larivera-UVG/Estimulador-Nervio-Vago/Estimulador/README.md

# Módulo Estimulador - Sistema Terapia VNS

## Descripción:

## Códigos:

### Arduino IDE:
Archivos .INO desarrollados en el editor de Arduino para configurar los módulos individuales del microcontrolador ATSAMD21E18A sobre la plataforma Trinket M0. Los archivos son independientes y solo el archivo .Estimulador recopila todas las funciones de los otros módulos para su funcionamiento.

* Administración de Energía
* Conversión Analógico-Digital
* Comunicación SPI
* Memoria EEPROM
* Módulación por Ancho de Pulso (PWM)
* Temporizadores/Contadores

## Esquemáticos:
Diseños de circuitos realizados para la fabricación de PCBs y simulaciones.

### Altium Designer
Esquemáticos y diseño de los PCBs para los prototipos. Se incluyen las librerias de los componentes usados y creados para los diseños. 

* Módulo de Alimentación y Comunicación USB
* Adaptador QFN a DIP
* Adaptador SOIC-8 A DIP
* Módulo Estimulador

### LTspice
Simulación de circuitos para la construcción de un convertidor de voltaje a corriente empleando componentes discretos (amplificadores operacionales, transistores, resistencias, etc).

* Convertidor Voltaje a Corriente Discreto

## Documentación
Documento escrito del trabajo de graduación en formado PDF, hoja de datos de componentes utilizados y documentos sobre teoría de la epilepsia, terapia VNS y manuales técnicos de dispositivos de neuromodulación de la Compañia LivaNova, PLC.

* Epilepsia y Sistema de Terapia VNS
* Microcontrolador SAMD21
* Plataforma Trinket M0
* Tesis

# Contacto:
Gustavo Ordoñez - Ord16357@uvg.edu.gt
