larivera-UVG/Estimulador-Nervio-Vago/Programador/Esquemáticos/README.md

# En este folder están los esquemáticos de simulación o pcbs creados

## Esquemático de comunicación inalámbrica en Proteus | 10 de agosto 2020

- ByteRead.pdsprj: contiene el esquemático utilizado en la simulación de los programas SendTry.ino y ReadTry.ino

## Actualización 22 de noviembre 2020

- Se elimina el archivo ByteRead.pdsprj
- Se añaden los esquemáticos y los diseños de PCBs de los módulos SPSGRF-868 y SPSGRFC. 

## Actualización 5 de enero 2021
- Se eliminaron los esquemáticos y diseños de PCB de los módulos de SPSGRF(C)-868. 
- Se añadieron esquemáticos de conexión entre controladores y módulos RF.
- [Fuente RF24-Arduino](https://create.arduino.cc/projecthub/muhammad-aqib/nrf24l01-interfacing-with-arduino-wireless-communication-0c13d4). Los pines CE y CSN se pueden cambiar en el código de la varilla programadora. 
- [Fuente RF24-NodeMCU](https://how2electronics.com/esp8266-nrf24l01-gateway-arduino-node/)
