larivera-UVG/Estimulador-Nervio-Vago/Programador/Codigo-Python/README.md

# En este folder están las archivos de Python utilizados para pruebas

## Pruebas de interfaz gráfica y envío de parámetros desde ésta | 7 de junio 2020

- ComAP_GUI.py: archivo con una interfaz gráfica capaz de enviar un número entero a un Arduino por medio de comunicación serial. Este número indica la frecuencia a la que debe resonar un buzzer. 

## Pruebas de comunicación inalámbrica entre dos Arduinos enviando los parámetros desde Python | 17 de agosto 2020

- ProteusCom.py: archivo que envía los parámetros de estimulación a un Arduino en Proteus. 

## Pruebas de comunicación inalámbrica físicas entre dos Arduinos enviando los parámetros desde Python | 30 de agosto 2020
- GUI_PP.py: archivo que envía los parámetros de estimulación a un Arduino de manera física por medio de una interfaz gráfica.
- GUI_PP.exe: interfaz gráfica convertida en aplicación para poder ser utilizada en cualquier computadora sin necesidad de tener Python instalado. 

## Pruebas de comunicación entre PC (GUI en Python) y controlador de la varilla (NodeMcu) por medio de WiFi | 26 de septiembre de 2020
- NMWiFi.py: archivo con genera la interfaz gráfica con capacidad de enviar los parámetros al controlador por medio de WiFi

## Interfaz gráfica mejorada con soporte para comuniación por WiFi y/o comuniación serial (por USB) | 29 de septiembre de 2020
- NewGUI.py: archivo que genera una interfaz gráfica mejorada con al capacidad de enviar parámetros al ESP8266 por medio de WiFi o por medio del cable USB.

## Actualización 22 de noviembre de 2020
- Solo se deja el archivo NewGUI que es el archivo que implementa el software de programación.
