larivera-UVG/Estimulador-Nervio-Vago/Programador/Documentación/README.md

# En este folder están los documentación utilizada y la versión actualizada del trabajo final de tesis

## Actualización 10 de agosto 2020
- Primera versión de tesis con resultados actualizados 

## Actualización 17 de agosto 2020
### Versión actualizada de tesis con los resultados: 
- Comunicación exitosa entre Proteus y Python. Se logran enviar los parámetros de estimulación desde la terminal de Spyder (Python)

## Actualización 24 de agosto 2020
### Versión actualizada de tesis con los resultados: 
- Comunicación exitosa entre Proteus y Python con GUI. Los parámetros de estimulación se envían desde una interfaz gráfica fácil de usar.
- Comunicación inalámbrica física exitosa con módulos RF 433 MHz. Se envía el número 500 desde el transmisor y el Arduino con el receptor imprime el valor en el monitor serial. 

## Actualización 31 de agosto 2020
### Versión actualizada de tesis con los resultados: 
- Comunicación inalámbrica física (con módulos RF de 433 MHz) entre dos Arduinos exitosa. Se logran enviar y recibir los parámetros de estimulación de forma exitosa. 
- Creación de una aplicación para poder utilizar la interfaz gráfica de forma universal, sin necesidad de instalar Python.
- Búsqueda automática del puerto USB (serial) en el que está conectado el Arduino transmisor. 

## Actualización 18 de septiembre 2020
### Versión actualizada de tesis
- Comunicación exitosa entre NodeMcu y Arduino utilizando los módulos RF de 433 MHz. Los valores se envían de forma repetida. Se debe cambiar el código para resolver este problema.
- Todas las secciones terminadas. 

## Actualización 28 de septiembre 2020
### Versión actualizada de tesis
- Cambios solicitados por el asesor. Mejoras en el texto. 

## Actualización 22 de noviembre 2020
- Versión actualizada de tesis
- Manual de Usuario para el Módulo de Programación - Versión 0.1 

### Documentación añadida de los componentes utilizados
- SPSGRF.pdf: hoja de datos del módulo RF SPSGRF
- spirit1.pdf: hoja de datos del módulo SPIRIT1, utilizado por el módulo SPSGRF

## Actualización 5 de enero 2021
- Se elimina la documentación del módulo SPSGRF, ya que este no se utilizó. 
- Se añadió la hoja de datos del módulo nRF24L01+ 
- La librería de Arduino IDE utilizada para el manejo del módulo RF se encuentra en el link de abajo: 
* [Librería nRF24L01+](http://tmrh20.github.io/RF24/index.html)
