larivera-UVG/Estimulador-Nervio-Vago/Estimulador/Documentación/Trinket M0/trinket_3v_microusb.jpg

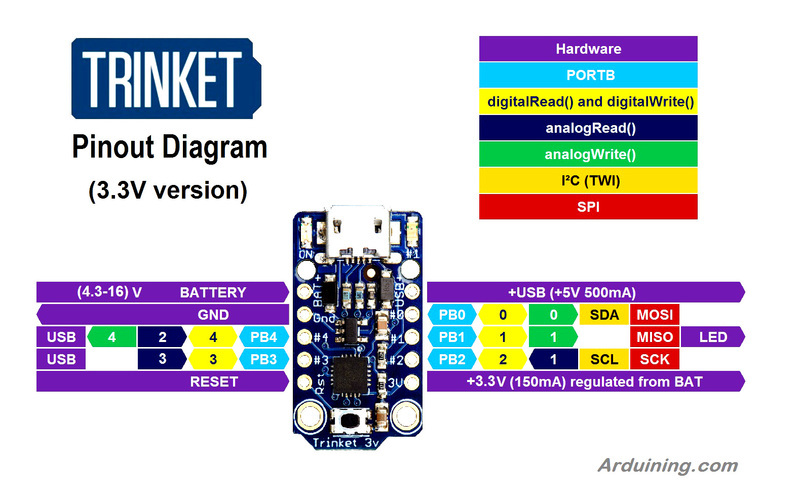
Estimulador/Documentación/Trinket M0/trinket_3v_microusb.jpg
