larivera-UVG/Estimulador-Nervio-Vago/Programador/Esquemáticos/nRF24Arduino.PNG

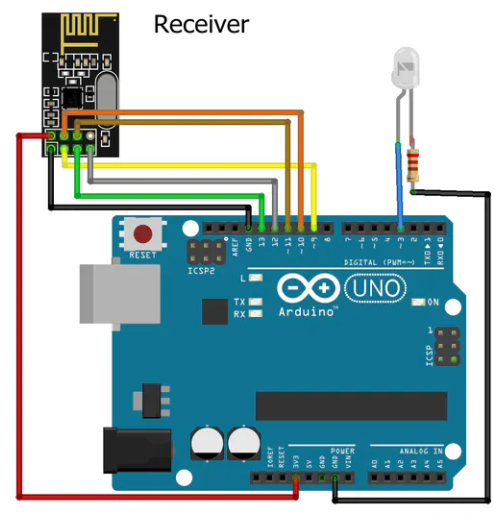
Programador/Esquemáticos/nRF24Arduino.PNG
