larivera-UVG/Estimulador-Nervio-Vago/Programador/Esquemáticos/nRF24NodeMCU.PNG

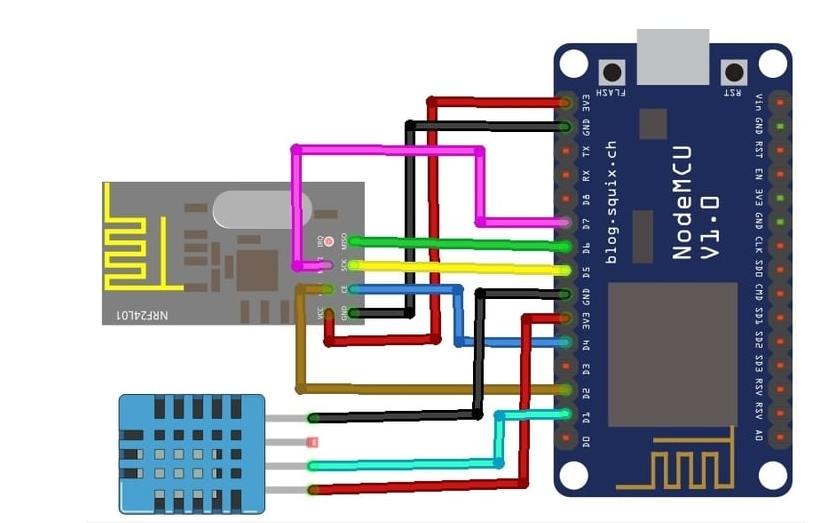
Programador/Esquemáticos/nRF24NodeMCU.PNG
