larivera-UVG/Estimulador-Nervio-Vago/(list of files, drawings)

Other design files:
Programador/Esquemáticos/ByteRead.pdsprj
Programador/Esquemáticos/SPSGRFCpcb.PcbDoc
Programador/Esquemáticos/SPSGRFCsheet.SchDoc
Programador/Esquemáticos/SPSGRFpcb.PcbDoc
Programador/Esquemáticos/SPSGRFSheet.SchDoc
