larivera-UVG/Estimulador-Nervio-Vago/(commit log)

2020-03-26 Creación de subfolders
2020-03-26 se cambiaron de lugar
2020-06-01 Generador de PWM
    Se configuro el modulo PWM para generar una señal cuadrada de estimulación (ON Time) con frecuencias de 1, 2, 5, 10, 15, 20, 25 y 30Hz con un ancho de pulso de 130, 250, 500, 750 y 1000 us. Esta versión emplea, como fuente de reloj, un reloj genérico con un oscilador de 32KHz.
2020-06-04 Tiempos ON/OFF de estimulación configurados
    Se configuro un timer para habilitar la señal PWM durante el intervalo ON (estimulación) y desactivar el PWM durante el intervalo OFF (reposo).
2020-06-06 Comentarios añadidos
    Los comentarios fueron mejorados, indicando las funciones y estructura de la programación de forma más clara. Variables e instrucciones no necesarias fueron removidas.
2020-06-08 Add files via upload
    Control del buzzer conectado a Arduino, recibiendo frecuencias desde una interfaz gráfica realizada en Python
    [BuzzerControl.ino]
2020-06-08 Add files via upload
    Archivo para la interfaz gráfica realizada en Python, diseñada para enviar frecuencias a Arduino
2020-07-26 Precisión del PWM
    Se redujo el error porcentual de las frecuencias generadas mediante el módulo PWM al asignar el reloj de 48MHz en lugar de 32KHz como fuente de pulsos para el Timer empleado en la generación de la señal.
    [PWM_Module.ino]
2020-07-27 Función de Rampa
    Se agregó la función de rampa hacia arriba y hacia abajo (con tiempo de 1 segundo c/u) para una frecuencia de 10Hz y una amplitud máxima de 2.75V.
2020-08-10 PCB SAMD21E18A
    Placa de pruebas para microcontrolador SAMD21E18A encapsulado QFN de 32 pines.
2020-08-10 PCB SAMD21E18A TQFP
    Placa de pruebas para el microcontrolador SAMD21E18A encapsulado TQFP de 32 pines.
2020-08-10 USB y Regulator de Voltage
    Placa de puerto micro usb para comunicar el IDE de Arduino con el microcontrolador SAMD21E18A y regular el voltaje de puerto usb de 5V a 3.3V.
2020-08-10 Módulo ADC
    Configuración del módulo ADC para realizar una lectura analógica de 12-bits en el puerto PA03.
2020-08-10 Módulo Timer
    Configuración del módulo Timer/Counter para realizar la temporización de la señal de estimulación y el intervalo de reposo de la terapia VNS (on/off time).
2020-08-10 Módulo PWM 32KHz
    Configuración del módulo generador de PWM con un reloj fuente de 32KHz para pruebas de los módulos trabajando con relojes de baja frecuencia y optimizar el consumo eléctrico total del microcontrolador durante los periodos de estimulación.
2020-08-10 Módulo Power Managment
    Configuración de módulo de administración de energía para reducir la frecuencia de reloj principal con el objetivo de reducir el consumo eléctrico del microcontrolador.
2020-08-10 Main Program
    Programa principal encargado de generar la señal de estimulación de la terapia VNS.
2020-08-10 Adafruit Trinket M0
    Documentación completa de la plataforma Trinket M0.
2020-08-10 SAMD21 Datasheet
    Hojas de datos para la familia de microcontroladores SAMD21.
2020-08-10 Tesis versión 10 de agosto 2020
2020-08-10 Tesis 10 de agosto 2020
2020-08-10 Código de Arduino utilizado con GUI preliminar
2020-08-10 Requerimiento de guardar archivos .ino en carpetas del mismo nombre
2020-08-10 Esquemático añadido
    [ByteRead.pdsprj]
2020-08-17 Función de Rampa mejorada
    Se generalizó el código de la función de rampa para todas aquellas frecuencias que puedan agruparse en grupos enteros. Por ejemplo, 2.75V a 30Hz -> 60 pulsos / 2 segundos por lo tanto tenemos 10 niveles de voltaje: 60/10 = 6. Agruparemos 6 pulsos por cada nivel de voltaje descendente/ascendente en la rampa.
2020-08-17 Tesis versión 17 de agosto 2020
2020-08-17 Tesis 17 de agosto
2020-08-20 Archivo de GUI en Python
2020-08-20 Comparacion de Frecuencias
2020-08-23 Módulo generador con rampa
    La función de rampa para frecuencias mayores o iguales a 10Hz se mejoró al evitar formar agrupaciones con los pulsos en la rampa de subida y bajada. En lugar, se realizó un barrido mediante el potenciometro digital desde el valor máximo y mínimo de la señal estimuladora.
2020-08-24 Tesis 24 de agosto
2020-08-25 Tesis versión 24 de Agosto de 2020
2020-08-27 Automatic Port y .exe
    Actualización del código de Python para identificar de manera automática en la que se encuentra el Arduino y creación de un .exe para poder utilizar el programa de forma universal
2020-08-30 Archivos para comunicación física agregados
2020-09-02 Tesis Versión 31 de Agosto de 2020
2020-09-07 Versión actualizada de tesis 7 septiembre 2020
2020-09-08 Condiciones de rampa
    Se añadieron condiciones para configurar la rampa. Dependiendo si la frecuencia es mayor o igual a 10Hz se activa la función de rampa, de lo contrario solo se lleva a cabo el control de amplitud.
2020-09-08 Tesis Versión 7 de Septiembre
2020-09-18 Tesis actualizada 18 de septiembre
2020-09-18 Códigos de transmisión y recepción RF utilizando NodeMcu
2020-09-19 Tesis versión 18 de Septiembre
2020-09-23 Cambios códigos transmisor y receptor
    Receptor: se añadió la capacidad de eliminar (no tomar en cuenta) los envíos múltiples.
    Transmisor: se añadió el soporte para comunicarse con la interfaz gráfica.
2020-09-27 Modo StandBy (bajo consumo)
    Se agregó la función de modo a bajo consumo o Stand By para optimizar el consumo de energía durante el intervalo de reposo. Esta función deja habilitados los relojes de 8MHz y 32KHz que se usan actualmente para el módulo TCC del PWM y el TC del contador estimulación/reposo respectivamente.
2020-09-28 Tesis 28 de septiembre
2020-09-29 Actualización WiFi-Serial
    La interfaz gráfica y la varilla programadora (ESP8266) se pueden enviar parámetros por medio de WiFi. Si hay fallos en la red, se pueden enviar los parámetros por medio de comunicación serial, utilizando un cable USB
2020-10-02 Versión actualizada de Tesis 2 de octubre 2020
2020-10-19 Documentación de los componentes RF usados
2020-10-19 Create ADC
2020-10-19 Descripción y estructura del proyecto
    Primera prueba de estructuración del proyecto.
2020-11-22 Actualización Carpeta de Arduino
2020-11-22 Actualización Carpeta de ESP8266
2020-11-22 Actualización Carpeta Esquemáticos
    [ByteRead.pdsprj, SPSGRFCpcb.PcbDoc, SPSGRFCsheet.SchDoc, SPSGRFSheet.SchDoc, SPSGRFpcb.PcbDoc]
2020-11-23 Guía Rápida de Inicio V1
2020-11-23 Convertidor de Precisión Voltaje a Corriente
    Documentación del convertidor de voltaje a corriente.
2020-12-02 Modo Bajo demanda (On-Demmand)
    Se agregó como entrada un sensor de Efecto Hall para activar por medio de un imán una dosis de terapia VNS con los mismos parámetros que el modo estándar (frecuencia, tiempo de estimulación, tiempo de reposo, ancho de pulso y frecuencia). Actualmente, la activación de este modo reinicia la dosis de la terapia VNS pero posteriormente deberá funcionar como una pausa a la dosis normal, es decir, guardara el tiempo de reposo o estimulación que haya quedado pendiente al activar el modo bajo demanda.
2020-12-30 Create nRFTry.ino
    Codigo para uso del modulo nRF24L01+ con NodeMcu
2021-01-03 Uso de nueva libreria para low power
2021-01-05 Cambio de nombre a SoftProg.py
2021-01-05 nRF24L01+ añadida
    Se añadió la documentación del módulo nRF24L01+ y se eliminó la del módulo SPSGRF-868
2021-01-05 Eliminación de archivos no necesarios
2021-01-05 Nuevo Diagrama de Funcionamiento
2021-01-05 Esquemáticos SPSGRF eliminados
    [SPSGRFCpcb.PcbDoc, SPSGRFCsheet.SchDoc, SPSGRFSheet.SchDoc, SPSGRFpcb.PcbDoc]
2021-01-05 Esquemáticos de conexión RF24
